ekchess/PET2_Companionv7/README.md

# PET2_Companionv7
Arduino-based companion board for model rocket timers and flight computers that monitors model rocket attitude and prevents dangerous airstarts. 
Included in the repository are the Arduino sketch (.ino) and assembly and operation instructions (.docx).
The PCB can be found at WWW.OSHPark.com under the name PET2_COMPANIONV7.
