ekchess/PET2_Companionv7/(commit log)

2017-04-03 Update README.md
    Added assembly instructions, Arduino sketch, and a reference to where the accompanying PCB can be found at OSHPark.
2017-09-26 MPU6050_Companion_Gyro_v3.ino
    This sketch uses the accelerometer sensors to determine initial attitude of rocket, and then uses only gyro sensors to calculate attitude once launch has been detected. This sketch should replace the prior sketch.
    [MPU6050_Companion_Gyro_v3.ino]
